hide4096/SaponseEx/README.md

# SaponseEx
マイクロマウス
RT社HM-Starterキットをベースに開発
