hide4096/SaponseEx/CAD/PCB/EncL_PCB.step

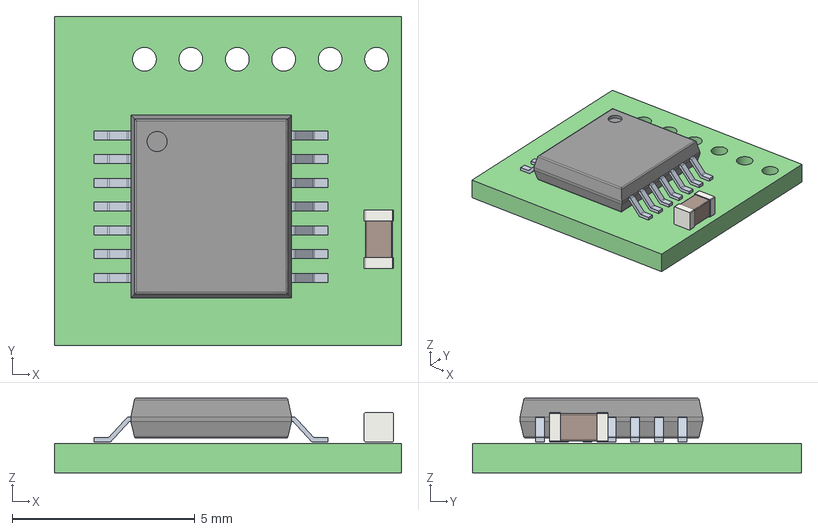
[picture p1: CAD file, 2022-10-14]
CAD/PCB/EncL_PCB.step
9.50 x 9.00 x 2.05 mm
_autosave-SaponseEx PCB
