hide4096/SaponseEx/(list of files, cad)

Other CAD files:
CAD/PCB/EncR_PCB.step
CAD/AIS2022/607ZZ Ball.ipt
CAD/AIS2022/607ZZ Inner ring.ipt
CAD/AIS2022/607ZZ Outer ring.ipt
CAD/AIS2022/607ZZ Shield.ipt
CAD/AIS2022/607ZZ.iam
CAD/AIS2022/673 Ball.ipt
CAD/AIS2022/673 Inner ring.ipt
CAD/AIS2022/673 Outer ring.ipt
CAD/AIS2022/673.iam
CAD/AIS2022/WA673SA Ball.ipt
CAD/AIS2022/WA673SA Inner ring.ipt
CAD/AIS2022/WA673SA Outer ring.ipt
CAD/AIS2022/WA673SA Shield.ipt
CAD/AIS2022/WA673SA.iam
CAD/Board_Parts/LBR127HLD.ipt
CAD/Board_Parts/Lipo.ipt
CAD/Board_Parts/MainBoard.ipt
CAD/Board_Parts/SNZS-M1_6-4.ipt
CAD/Board_Parts/SubBoard.ipt
CAD/CoreLessMotor.ipt
CAD/FL673ZZ.ipt
CAD/FanTurbo.ipt
CAD/FanWing.ipt
CAD/FanWing_open.ipt
CAD/Gear.iam
CAD/Gear/デザイン アクセラレータ/OldVersions/平歯車1.0011.iam
CAD/Gear/デザイン アクセラレータ/OldVersions/平歯車11.0017.ipt
CAD/Gear/デザイン アクセラレータ/mirror/OldVersions/平歯車11_MIR1.0001.ipt
CAD/Gear/デザイン アクセラレータ/mirror/OldVersions/平歯車1_MIR1.0001.iam
CAD/Gear/デザイン アクセラレータ/mirror/平歯車11_MIR.ipt
CAD/Gear/デザイン アクセラレータ/mirror/平歯車11_MIR1.ipt
CAD/Gear/デザイン アクセラレータ/mirror/平歯車1_MIR.iam
CAD/Gear/デザイン アクセラレータ/mirror/平歯車1_MIR1.iam
CAD/Gear/デザイン アクセラレータ/平歯車1.iam
CAD/Gear/デザイン アクセラレータ/平歯車11.ipt
CAD/Gear/デザイン アクセラレータ/平歯車21.ipt
CAD/Gear/デザイン アクセラレータ/足回り_ミラー/OldVersions/平歯車11_MIR1.0001.ipt
CAD/Gear/デザイン アクセラレータ/足回り_ミラー/OldVersions/平歯車1_MIR1.0001.iam
CAD/Gear/デザイン アクセラレータ/足回り_ミラー/平歯車11_MIR.ipt
CAD/Gear/デザイン アクセラレータ/足回り_ミラー/平歯車11_MIR1.ipt
CAD/Gear/デザイン アクセラレータ/足回り_ミラー/平歯車1_MIR.iam
CAD/Gear/デザイン アクセラレータ/足回り_ミラー/平歯車1_MIR1.iam
CAD/GearWheel.ipt
CAD/HeikoPin.ipt
CAD/Magnet.iam
CAD/Magnet.ipt
CAD/MagnetMounter.ipt
CAD/MagnetStopper.ipt
CAD/Magnet_Simple.ipt
CAD/MotorMount.ipt
CAD/MotorMount_New.ipt
CAD/OldVersions/CoreLessMotor.0004.ipt
CAD/OldVersions/FL673ZZ.0032.ipt
CAD/OldVersions/FanWing.0003.ipt
CAD/OldVersions/Gear.0013.iam
CAD/OldVersions/HeikoPin.0036.ipt
CAD/OldVersions/Magnet.0031.ipt
CAD/OldVersions/MagnetMounter.0034.ipt
CAD/OldVersions/Magnet_Simple.0024.ipt
CAD/OldVersions/MotorMount.0064.ipt
CAD/OldVersions/MotorMount_New.0007.ipt
CAD/OldVersions/RT-PN v2.0031.ipt
CAD/OldVersions/SaponseEx.0015.idw
CAD/OldVersions/SaponseEx.0035.iam
CAD/OldVersions/Skirt.0027.ipt
CAD/OldVersions/Spacer.0031.ipt
CAD/OldVersions/Stopper.0043.ipt
CAD/OldVersions/Tire.0034.ipt
CAD/OldVersions/足回り.0065.iam
CAD/PCB/Brains_PCB.ipt
CAD/PCB/EncL_PCB.ipt
CAD/PCB/EncR_PCB.ipt
CAD/PCB/OldVersions/Brains_PCB.0002.ipt
CAD/PCB/OldVersions/EncL_PCB.0001.ipt
CAD/PCB/OldVersions/EncR_PCB.0001.ipt
CAD/PCB/OldVersions/SaponseEx_PCB.0004.ipt
CAD/PCB/SaponseEx_PCB.ipt
CAD/RT-PN v2.ipt
CAD/SaponseEx.iam
CAD/SaponseEx.idw
CAD/Skirt.ipt
CAD/Spacer.ipt
CAD/Stopper.ipt
CAD/Tire.ipt
CAD/mirror/CoreLessMotor_MIR.ipt
CAD/mirror/FL673ZZ_MIR.ipt
CAD/mirror/Gear_MIR.iam
CAD/mirror/HeikoPin_MIR.ipt
CAD/mirror/MagnetMounter_MIR.ipt
CAD/mirror/Magnet_MIR.iam
CAD/mirror/Magnet_MIR.ipt
CAD/mirror/Magnet_Simple_MIR.ipt
CAD/mirror/MotorMount_New_MIR.ipt
CAD/mirror/OldVersions/Gear_MIR.0001.iam
CAD/mirror/OldVersions/MotorMount_New_MIR.0001.ipt
CAD/mirror/OldVersions/Stopper_MIR.0001.ipt
CAD/mirror/OldVersions/足回り_MIR.0002.iam
CAD/mirror/RT-PN v2_MIR.ipt
CAD/mirror/Spacer_MIR.ipt
CAD/mirror/Stopper_MIR.ipt
CAD/mirror/Tire_MIR.ipt
CAD/mirror/足回り_MIR.iam
CAD/吸引/Fan.ipt
CAD/吸引/Fan2.ipt
CAD/吸引/Fan3.ipt
CAD/吸引/Fan4.ipt
CAD/吸引/Fan5.ipt
CAD/吸引/FanMotor.ipt
CAD/吸引/FanMotorMount.ipt
CAD/吸引/OldVersions/Fan.0007.ipt
CAD/吸引/OldVersions/Fan3.0001.ipt
CAD/吸引/OldVersions/Fan4.0002.ipt
CAD/吸引/OldVersions/Fan5.0006.ipt
CAD/吸引/OldVersions/FanMotorMount.0026.ipt
CAD/吸引テスト/Base.ipt
CAD/吸引テスト/OldVersions/mounter.0003.ipt
CAD/吸引テスト/mounter.ipt
CAD/吸引テスト/mounter_top.ipt
CAD/足回り.iam
