hide4096/SaponseEx/PCB/SaponseEx.pdf

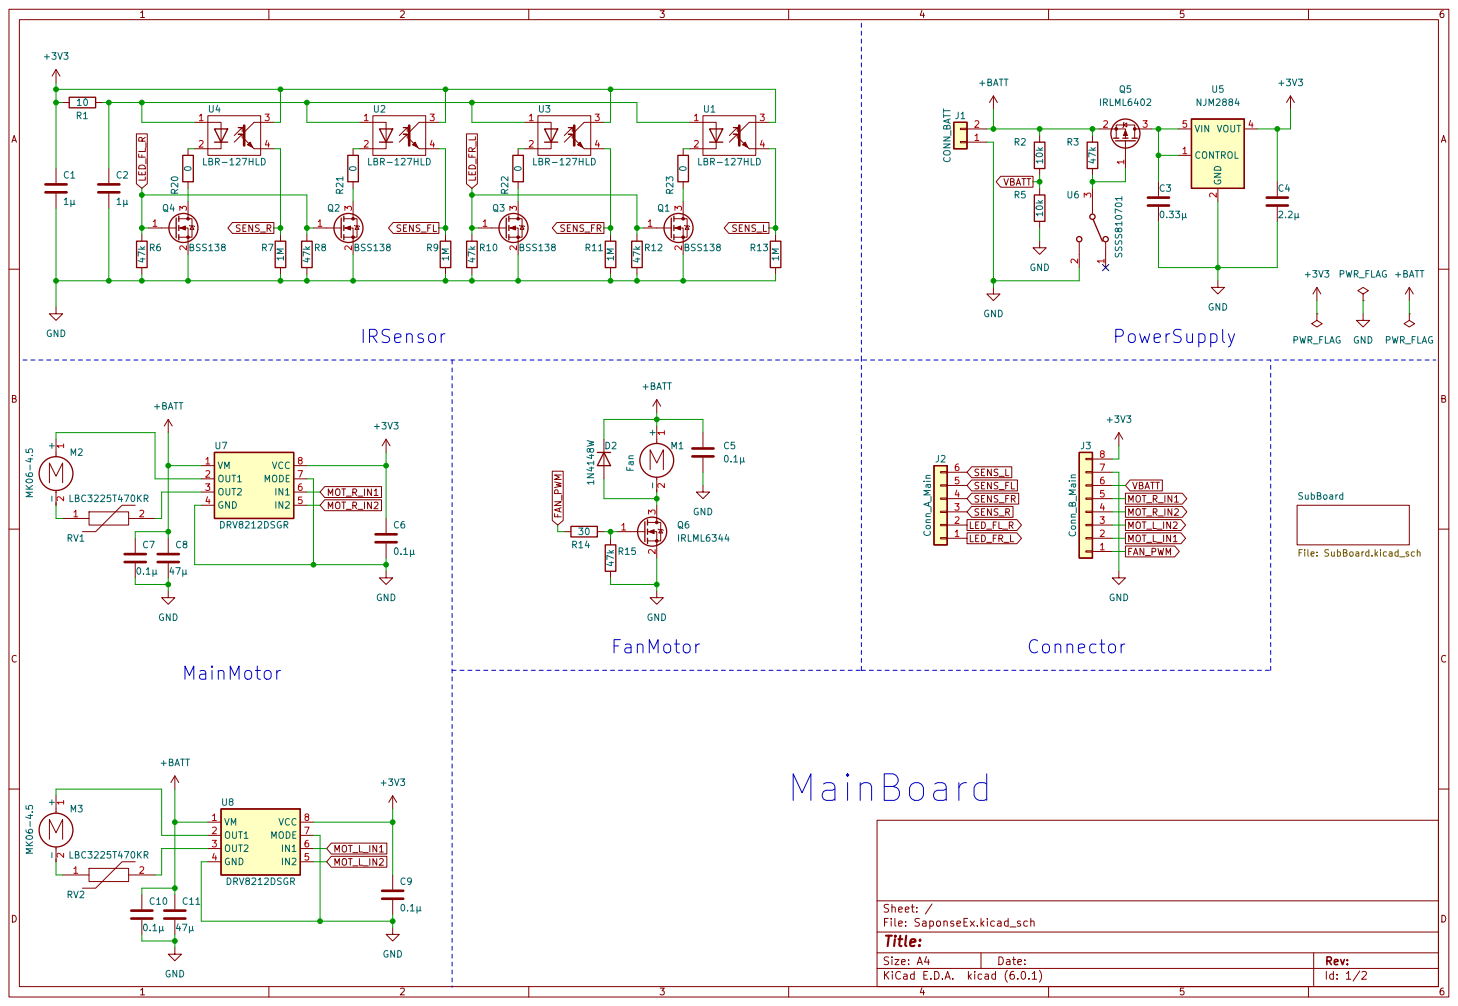
[picture p2: page 1]

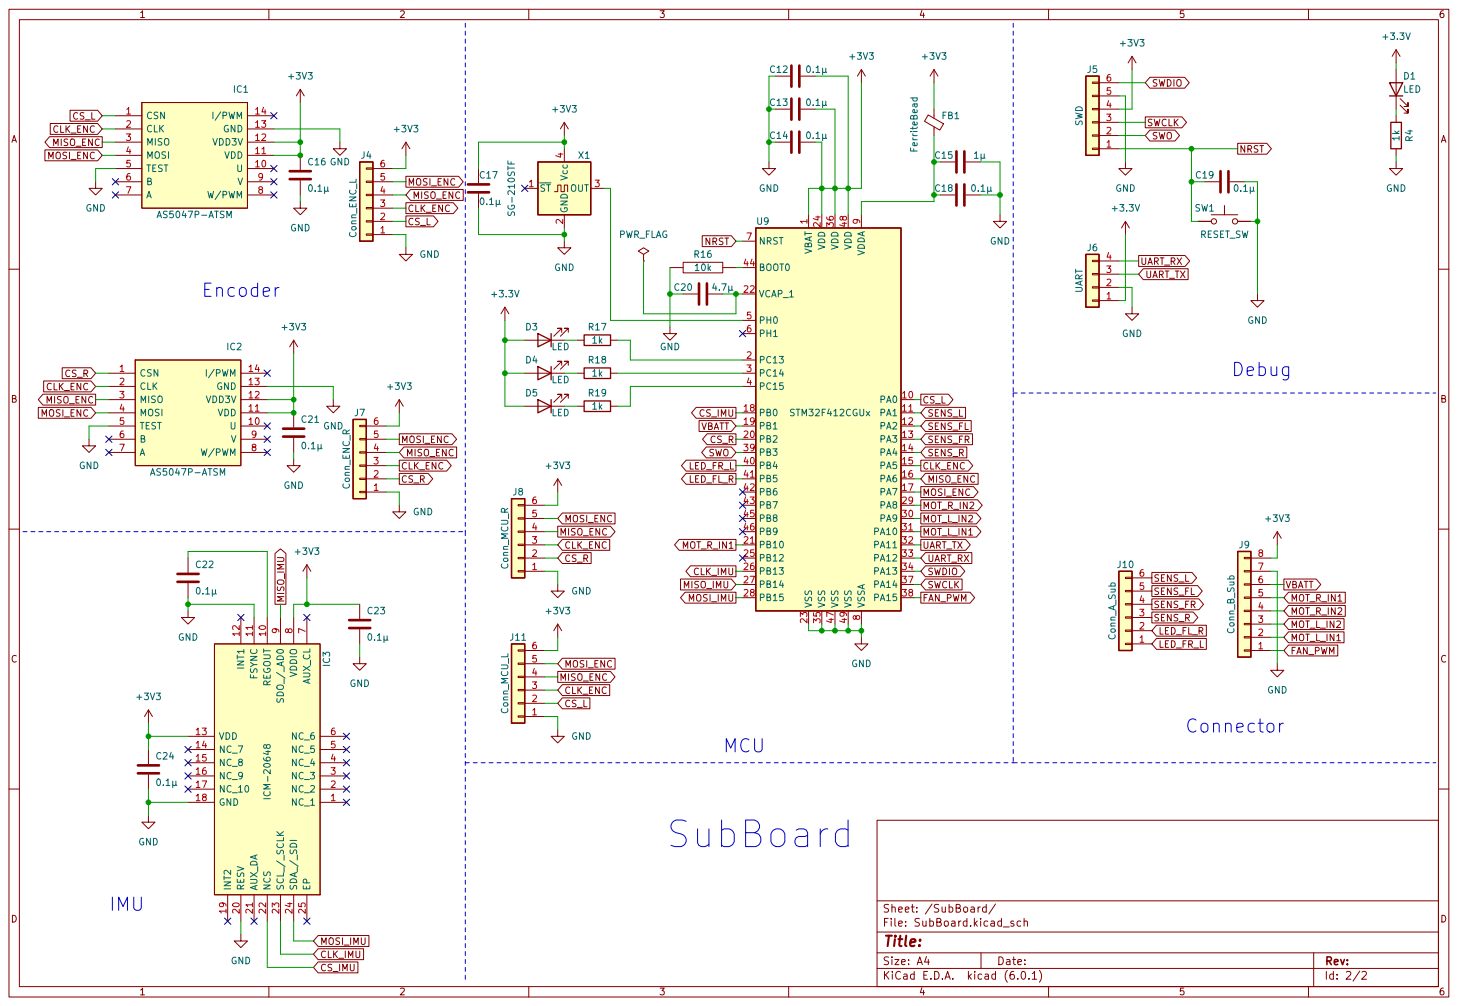
[picture p3: page 2]

8 VDDA U9 9 STM32F412CGUx NC_1 1 REGOUT 10 FSYNC 11 INT1 12 VDD 13 NC_7 14 NC_8 15 NC_9 16 NC_10 17 GND 18 INT2 19 NC_2 2 RESV 20 AUX_DA 21 NCS 22 SCL_/_SCLK 23 SDA_/_SDI 24 EP 25 NC_3 3 NC_4 4 NC_5 5 NC_6 6 AUX_CL

1 PA0 10 PA1 11 PA2 12 PA3 13 PA4 14 PA5 15 PA6 16 PA7 17 PB0 18 PB1 19 PC13 2 PB2 20 PB10 21 VCAP_1 22 VSS 23 VDD 24 PB12 25 PB13 26 PB14 27 PB15 28 PA8 29 PC14 3 PA9 30 PA10 31 PA11 32 PA12 33 PA13 34 VSS 35 VDD 36 PA14 37 PA15 38 PB3 39 PC15 4 PB4 40 PB5 41 PB6 42 PB7 43 BOOT0 44 PB8 45 PB9 46 VSS 47 VDD 48 VSS 49 PH0 5 PH1 6 NRST 7 VSSA

File: SubBoard.kicad_sch Sheet: /SubBoard/
Id: 2/2 Title:
