hide4096/SaponseEx/PCB/SaponseEx.kicad_pcb

## KiCad design PCB/SaponseEx.kicad_pcb (2022-07-28)

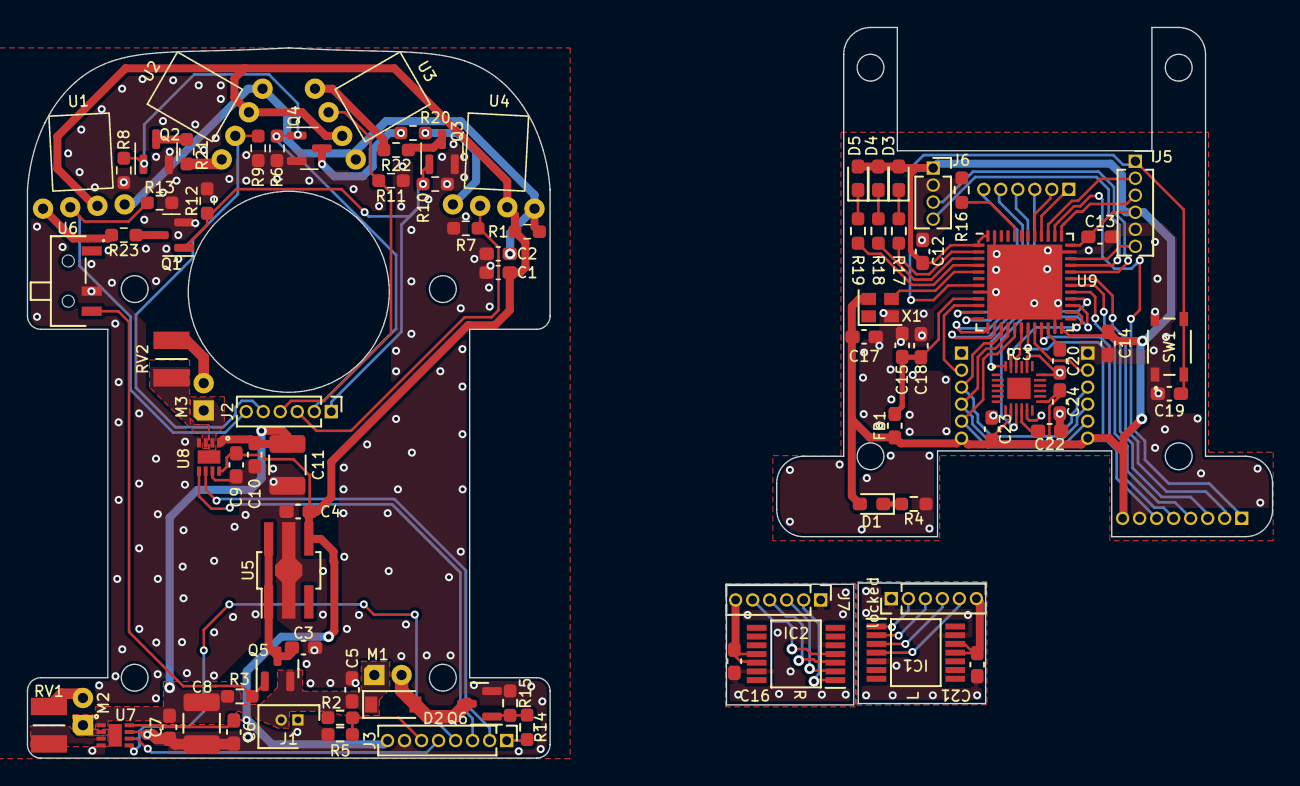
[picture p4: board SaponseEx.kicad_pcb from above]

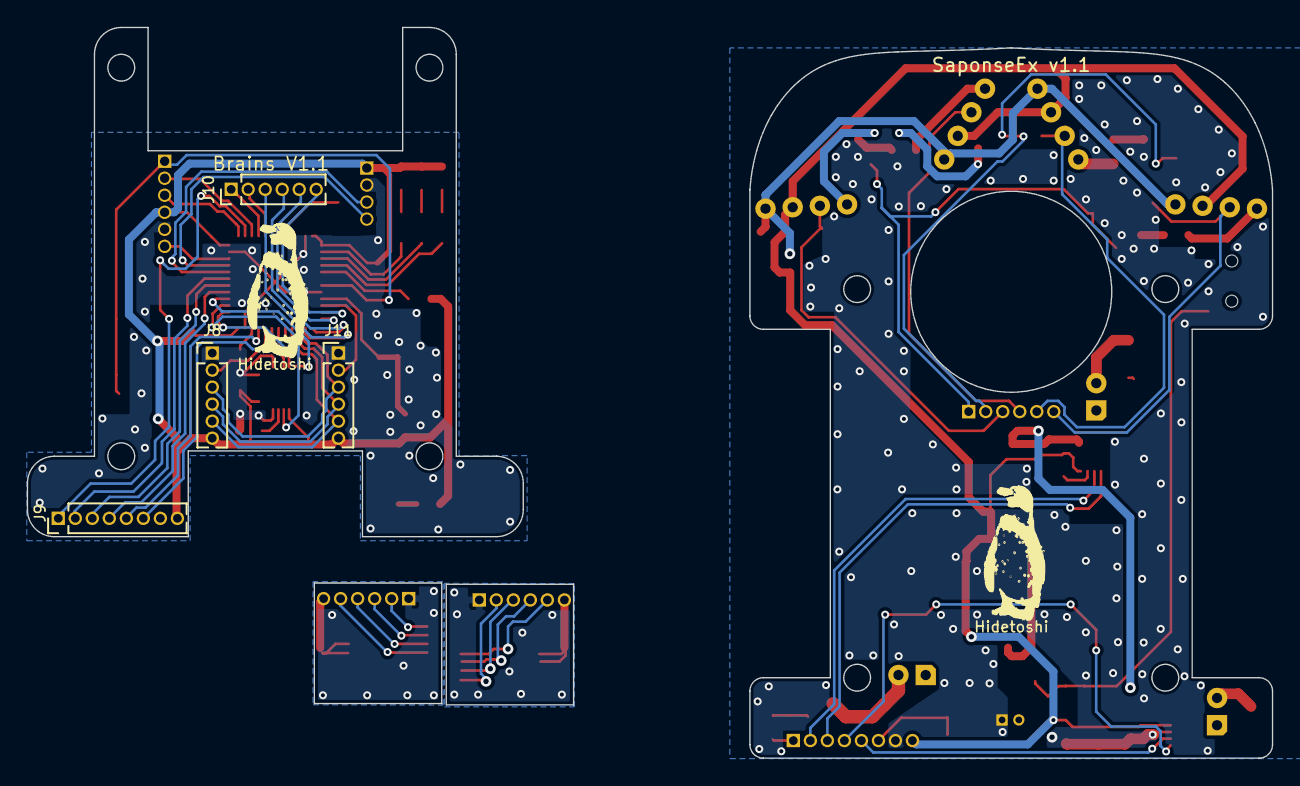
[picture p5: board SaponseEx.kicad_pcb from below]

Board: 2 copper layers, 92.9 x 54.5 mm, 89 parts (4 on the bottom side), 61 nets.

Parts:
C1, C2, C15: 1μ; C_0603_1608Metric_Pad1.08x0.95mm_HandSolder
C3: 0.33μ; C_0603_1608Metric_Pad1.08x0.95mm_HandSolder
C4: 2.2μ; C_0603_1608Metric_Pad1.08x0.95mm_HandSolder
C5, C6, C7, C9, C10, C12, C13, C14, C16, C17, C18, C19, C21, C22, C23, C24: 0.1μ; C_0603_1608Metric_Pad1.08x0.95mm_HandSolder
C8, C11: 47μ; C_1210_3225Metric_Pad1.33x2.70mm_HandSolder
C20: 4.7μ; C_0603_1608Metric_Pad1.08x0.95mm_HandSolder
D1, D3, D4, D5: LED; LED_0603_1608Metric_Pad1.05x0.95mm_HandSolder
D2: 1N4148W; D_SOD-123
FB1: FerriteBead; L_0603_1608Metric_Pad1.05x0.95mm_HandSolder
IC1, IC2: AS5047P-ATSM; SOP65P640X120-14N
IC3: ICM-20648; QFN40P300X300X95-25N-D
J1: CONN_BATT; SHDR2W35P0X125_1X2_425X320X420P
J2: Conn_A_Main; PinHeader_1x06_P1.27mm_Vertical
J3: Conn_B_Main; PinHeader_1x08_P1.27mm_Vertical
J5: SWD; PinSocket_1x06_P1.27mm_Vertical
J6: UART; PinSocket_1x04_P1.27mm_Vertical
J7: Conn_ENC_R; PinHeader_1x06_P1.27mm_Vertical
J8: Conn_MCU_R; PinHeader_1x06_P1.27mm_Vertical
J9: Conn_B_Sub; PinHeader_1x08_P1.27mm_Vertical
J10: Conn_A_Sub; PinHeader_1x06_P1.27mm_Vertical
J11: Conn_MCU_L; PinHeader_1x06_P1.27mm_Vertical
M1: Fan; Motor
M2, M3: MK06-4.5; Motor
Q1, Q2, Q3, Q4: BSS138; SOT-23
Q5: IRLML6402; SOT-23
Q6: IRLML6344; SOT-23
R1: 10; R_0603_1608Metric_Pad0.98x0.95mm_HandSolder
R2, R5, R16: 10k; R_0603_1608Metric_Pad0.98x0.95mm_HandSolder
R3, R6, R8, R10, R12, R15: 47k; R_0603_1608Metric_Pad0.98x0.95mm_HandSolder
R4, R17, R18, R19: 1k; R_0603_1608Metric_Pad0.98x0.95mm_HandSolder
R7, R9, R11, R13: 1M; R_0603_1608Metric_Pad0.98x0.95mm_HandSolder
R14: 30; R_0603_1608Metric_Pad0.98x0.95mm_HandSolder
R20, R21, R22, R23: 0; R_0603_1608Metric_Pad0.98x0.95mm_HandSolder
RV1, RV2: LBC3225T470KR; VARC3225X270N
SW1: RESET_SW; SKRPABE010
U1, U2, U3, U4: LBR-127HLD
U5: NJM2884; SOT-89-5_Handsoldering
U6: SSSS810701
U7, U8: DRV8212DSGR; SON50P200X200X80-9N
U9: STM32F412CGUx; QFN-48-1EP_7x7mm_P0.5mm_EP5.6x5.6mm
X1: SG-210STF; Oscillator_SMD_SeikoEpson_SG210-4Pin_2.5x2.0mm
locked: Conn_ENC_L; PinHeader_1x06_P1.27mm_Vertical

Connections:
+3V3: C1.1, C4.1, C6.1, C9.1, C12.2, C13.2, C14.2, C16.1, C17.1, C21.1, C23.1, C24.1, D1.2 (A), D3.2 (A), D4.2 (A), D5.2 (A), FB1.2, IC1.11 (VDD), IC1.12 (VDD3V), IC2.11 (VDD), IC2.12 (VDD3V), IC3.8 (VDDIO), IC3.13 (VDD), J3.8, J5.4, J6.1, J7.6, J8.6, J9.8, J11.6, R1.1, U1.3, U2.3, U3.3, U4.3, U5.4 (VOUT), U7.8 (VCC), U8.8 (VCC), U9.1 (VBAT), U9.24 (VDD), U9.36 (VDD), U9.48 (VDD), X1.4 (Vcc), locked.6
+BATT: C5.1, C7.1, C8.1, C10.1, C11.1, D2.1 (K), J1.2, M1.1 (+), Q5.2 (S), R2.1, R3.1, U7.1 (VM), U8.1 (VM)
CLK_ENC: IC1.2 (CLK), IC2.2 (CLK), J7.3, J8.3, J11.3, U9.15 (PA5), locked.3
CLK_IMU: IC3.23 (SCL_/_SCLK), U9.26 (PB13)
CS_IMU: IC3.22 (NCS), U9.18 (PB0)
CS_L: IC1.1 (CSN), J11.2, U9.10 (PA0), locked.2
CS_R: IC2.1 (CSN), J7.2, J8.2, U9.20 (PB2)
FAN_PWM: J3.1, J9.1, R14.1, U9.38 (PA15)
GND: C1.2, C2.2, C3.2, C4.2, C5.2, C6.2, C7.2, C8.2, C9.2, C10.2, C11.2, C12.1, C13.1, C14.1, C15.2, C16.2, C17.2, C18.2, C19.2, C20.1, C21.2, C22.2, C23.2, C24.2, IC1.5 (TEST), IC1.13 (GND), IC2.5 (TEST), IC2.13 (GND), IC3.11 (FSYNC), IC3.18 (GND), IC3.20 (RESV), J1.1, J3.7, J5.5, J6.2, J7.1, J8.1, J9.7, J11.1, Q1.2 (S), Q2.2 (S), Q3.2 (S), Q4.2 (S), Q6.2, R4.2, R5.2, R6.2, R7.2, R8.2, R9.2, R10.2, R11.2, R12.2, R13.2, R15.2, R16.1, SW1.1 (A), SW1.2 (A), U5.2 (GND), U6.2, U7.4 (GND), U7.7 (MODE), U8.4 (GND), U8.7 (MODE), U9.8 (VSSA), U9.23 (VSS), U9.35 (VSS), U9.47 (VSS), U9.49 (VSS), X1.2 (GND), locked.1
LED_FL_R: J2.2, J10.2, Q2.1 (G), Q4.1 (G), R6.1, R8.1, U9.41 (PB5)
LED_FR_L: J2.1, J10.1, Q1.1 (G), Q3.1 (G), R10.1, R12.1, U9.40 (PB4)
MISO_ENC: IC1.3 (MISO), IC2.3 (MISO), J7.4, J8.4, J11.4, U9.16 (PA6), locked.4
MISO_IMU: IC3.9 (SDO_/_AD0), U9.27 (PB14)
MOSI_ENC: IC1.4 (MOSI), IC2.4 (MOSI), J7.5, J8.5, J11.5, U9.17 (PA7), locked.5
MOSI_IMU: IC3.24 (SDA_/_SDI), U9.28 (PB15)
MOT_L_IN1: J3.2, J9.2, U8.6 (IN1), U9.31 (PA10)
MOT_L_IN2: J3.3, J9.3, U8.5 (IN2), U9.30 (PA9)
MOT_R_IN1: J3.5, J9.5, U7.6 (IN1), U9.21 (PB10)
MOT_R_IN2: J3.4, J9.4, U7.5 (IN2), U9.29 (PA8)
NRST: C19.1, J5.1, SW1.3 (B), SW1.4 (B), U9.7 (NRST)
unnamed: C2.1, R1.2, U1.1, U2.1, U3.1, U4.1
unnamed: C3.1, Q5.3 (D), U5.1 (CONTROL), U5.5 (VIN)
unnamed: C15.1, C18.1, FB1.1, U9.9 (VDDA)
unnamed: C20.2, U9.22 (VCAP_1)
unnamed: C22.1, IC3.10 (REGOUT)
unnamed: D1.1 (K), R4.1
unnamed: D2.2 (A), M1.2 (-), Q6.3
unnamed: D3.1 (K), R17.1
unnamed: D4.1 (K), R18.1
unnamed: D5.1 (K), R19.1
unnamed: M2.1 (+), U7.2 (OUT1)
unnamed: M2.2 (-), RV1.1
unnamed: M3.1 (+), U8.2 (OUT1)
unnamed: M3.2 (-), RV2.1
unnamed: Q1.3 (D), R23.1
unnamed: Q2.3 (D), R21.1
unnamed: Q3.3 (D), R22.1
unnamed: Q4.3 (D), R20.1
unnamed: Q5.1 (G), R3.2, U6.3
unnamed: Q6.1, R14.2, R15.1
unnamed: R16.2, U9.44 (BOOT0)
unnamed: R17.2, U9.2 (PC13)
unnamed: R18.2, U9.3 (PC14)
unnamed: R19.2, U9.4 (PC15)
unnamed: R20.2, U4.2
unnamed: R21.2, U2.2
unnamed: R22.2, U3.2
unnamed: R23.2, U1.2
unnamed: RV1.2, U7.3 (OUT2)
unnamed: RV2.2, U8.3 (OUT2)
unnamed: U9.5 (PH0), X1.3 (OUT)
SENS_FL: J2.5, J10.5, R9.1, U2.4, U9.12 (PA2)
SENS_FR: J2.4, J10.4, R11.1, U3.4, U9.13 (PA3)
SENS_L: J2.6, J10.6, R13.1, U1.4, U9.11 (PA1)
SENS_R: J2.3, J10.3, R7.1, U4.4, U9.14 (PA4)
SWCLK: J5.3, U9.37 (PA14)
SWDIO: J5.6, U9.34 (PA13)
SWO: J5.2, U9.39 (PB3)
UART_RX: J6.4, U9.33 (PA12)
UART_TX: J6.3, U9.32 (PA11)
VBATT: J3.6, J9.6, R2.2, R5.1, U9.19 (PB1)
