hide4096/SaponseEx/SaponseEx.ioc

Mcu.UserName=STM32F412CGUx
PA0.GPIO_Label=CS_L
PA0.Signal=GPIO_Output
PA1.GPIO_Label=SENS_L
PA1.Signal=ADCx_IN1
PA10.GPIO_Label=MOT_L_IN1
PA10.Signal=S_TIM1_CH3
PA11.Signal=USART6_TX
PA12.Signal=USART6_RX
PA13.Signal=SYS_JTMS-SWDIO
PA14.Signal=SYS_JTCK-SWCLK
PA15.GPIO_Label=FAN
PA15.Signal=GPIO_Output
PA2.GPIO_Label=SENS_FL
PA2.Signal=ADCx_IN2
PA3.GPIO_Label=SENS_FR
PA3.Signal=ADCx_IN3
PA4.GPIO_Label=SENS_R
PA4.Signal=ADCx_IN4
PA5.GPIO_Label=CLK_ENC
PA5.Signal=SPI1_SCK
PA6.GPIO_Label=MISO_ENC
PA6.Signal=SPI1_MISO
PA7.GPIO_Label=MOSI_ENC
PA7.Signal=SPI1_MOSI
PA8.GPIO_Label=MOT_R_IN2
PA8.Signal=S_TIM1_CH1
PA9.GPIO_Label=MOT_L_IN2
PA9.Signal=S_TIM1_CH2
PB0.GPIO_Label=CS_IMU
PB0.Signal=GPIO_Output
PB1.GPIO_Label=VBATT
PB1.Signal=ADCx_IN9
PB10.GPIO_Label=MOT_R_IN1
PB10.Signal=S_TIM2_CH3
PB13.GPIO_Label=CLK_IMU
PB13.Signal=SPI2_SCK
PB14.GPIO_Label=MISO_IMU
PB14.Signal=SPI2_MISO
PB15.GPIO_Label=MOSI_IMU
PB15.Signal=SPI2_MOSI
PB2.GPIO_Label=CS_R
PB2.Signal=GPIO_Output
PB3.Signal=SYS_JTDO-SWO
PB4.GPIO_Label=LED_FR_L
PB4.Signal=GPIO_Output
PB5.GPIO_Label=LED_FL_R
PB5.Signal=GPIO_Output
PC13.GPIO_Label=D3
PC13.Signal=GPIO_Output
PC14-OSC32_IN.GPIO_Label=D4
PC14-OSC32_IN.Signal=GPIO_Output
PC15-OSC32_OUT.GPIO_Label=D5
PC15-OSC32_OUT.Signal=GPIO_Output
