hide4096/SaponseEx/Main/Src/motor.c

/* 
#####################################
    Motor Control & Encoder & IMU
#####################################
*/

#include"motor.h"

static int16_t b_encR_val=0,b_encL_val=0;
static float b_spd =0;
static float r_yaw = 0,r_yaw_new = 0,r_b_yaw;
static float before_spd=0.;
static float before_angvel=0.;
static float spdR,spdL;

uint8_t runmode=DISABLE_MODE;
uint8_t wallfix_is = DISABLE_MODE;
int8_t turndir = LEFT;
float spd,deg,len;
float accel = 0.,ang_accel = 0.;
float max_spd = 0.;
float max_angvel = 0.;
float angvel,r_yaw_ref;
float tgt_spd=0.,tgt_angvel=0.;
float tvR = 0.,tvL=0.;
int16_t encR_val,encL_val;
int16_t d_encR_val,d_encL_val;

float I_spd = 0.;
float I_angvel = 0.;
int I_error = 0.;


AS5047P_Instance encR;
AS5047P_Instance encL;

void SetDutyRatio(float motL,float motR,uint8_t motR_isCW,uint8_t motL_isCW){

  if(runmode != DISABLE_MODE){
    if(motR > 1.0) motR = 1.0;
    if(motL > 1.0) motL = 1.0;

    
    if(motL_isCW){
      __HAL_TIM_SET_COMPARE(&htim1,TIM_CHANNEL_2,(1.0-motL)*MTPERIOD);
      __HAL_TIM_SET_COMPARE(&htim1,TIM_CHANNEL_3,MTPERIOD);  
    }else{
      __HAL_TIM_SET_COMPARE(&htim1,TIM_CHANNEL_2,MTPERIOD);
      __HAL_TIM_SET_COMPARE(&htim1,TIM_CHANNEL_3,(1.0-motL)*MTPERIOD);
    }

    if(!motR_isCW){
      __HAL_TIM_SET_COMPARE(&htim1,TIM_CHANNEL_1,(1.0-motR)*MTPERIOD);
      __HAL_TIM_SET_COMPARE(&htim2,TIM_CHANNEL_3,MTPERIOD);
    }else{
      __HAL_TIM_SET_COMPARE(&htim1,TIM_CHANNEL_1,MTPERIOD);
      __HAL_TIM_SET_COMPARE(&htim2,TIM_CHANNEL_3,(1.0-motR)*MTPERIOD);
    }

  }else{
    __HAL_TIM_SET_COMPARE(&htim1,TIM_CHANNEL_1,MTPERIOD);
    __HAL_TIM_SET_COMPARE(&htim2,TIM_CHANNEL_3,MTPERIOD);
    __HAL_TIM_SET_COMPARE(&htim1,TIM_CHANNEL_2,MTPERIOD);
    __HAL_TIM_SET_COMPARE(&htim1,TIM_CHANNEL_3,MTPERIOD);
  }
}

void GetSpeed(){

  //エンコーダ読む
  encR_val = AS5047P_ReadPosition(&encR, AS5047P_OPT_ENABLED);
  encL_val = AS5047P_ReadPosition(&encL, AS5047P_OPT_ENABLED);
	if(AS5047P_ErrorPending(&encR)) AS5047P_ErrorAck(&encR);
	if(AS5047P_ErrorPending(&encL)) AS5047P_ErrorAck(&encL);

  //差分とる
  d_encR_val = encR_val - b_encR_val;
  d_encL_val = b_encL_val -  encL_val;
  b_encR_val = encR_val;
  b_encL_val = encL_val;

  //0と16383とかまたいだ時の処理
  //秒速98.2m/s超えるとバグる（笑）
  if(d_encR_val > ENC_HALF)   d_encR_val -= ENC_MAX-1;
  if(d_encR_val < -ENC_HALF)  d_encR_val += ENC_MAX-1;
  if(d_encL_val > ENC_HALF)   d_encL_val -= ENC_MAX-1;
  if(d_encL_val < -ENC_HALF)  d_encL_val += ENC_MAX-1;

  //進んだ距離計算する
  float lenR = (float)d_encR_val * (float)PPMM;
  float lenL = (float)d_encL_val * (float)PPMM;
  //走行距離に入れる
  len += (lenR + lenL) / 2.0;

  //進んだ距離(mm)から速度(m/s)計算する
  spdR = (lenR / 1000.) / DELTA_T;
  spdL = (lenL / 1000.) / DELTA_T;

  //機体全体の速度を計算する
  float enc_spd = (spdL + spdR) / 2.0;
  spd = ALPHA*(b_spd + accelY()*9.8*DELTA_T) + (1-ALPHA)*enc_spd; 
  b_spd = spd;
}

void ControlDuty(){
  float vR = 0.,vL = 0.;

  //速度生成

  switch(runmode){
    case STRAIGHT_MODE:
      tgt_spd += accel/1000.;
      if(tgt_spd > max_spd) tgt_spd = max_spd;
      break;
    
    case TURN_MODE:
      tgt_spd += accel/1000.;
      if(tgt_spd > max_spd) tgt_spd = max_spd;

      tgt_angvel += ang_accel/1000.0;
      if(turndir == LEFT){
        if(tgt_angvel > max_angvel) tgt_angvel = max_angvel;
      }else if(turndir == RIGHT){
        if(tgt_angvel < max_angvel) tgt_angvel = max_angvel;
      }
      break;
  }

  //壁制御
  if(runmode == STRAIGHT_MODE){
    if(wallfix_is == ENABLE_MODE){
      //壁あるか確認
      uint8_t fl_wall_is = 0,fr_wall_is = 0;
      if(sensval[FL] >= WALL_TH_FL) fl_wall_is = 1;
      if(sensval[FR] >= WALL_TH_FR) fr_wall_is = 1;

      /*
        壁との距離から目標コースとのずれを測る
        壁の有無に応じて切り替えるよ
      */

      int error = 0;
      if(fl_wall_is && fr_wall_is){
        error = (sensval[FR] - REF_FR) - (sensval[FL] - REF_FL); 
      }else if(fl_wall_is){
        error = (sensval[FL] - REF_FL)*-2;
      }else if(fr_wall_is){
        error = (sensval[FR] - REF_FR)*2;
      }

      //PIDして目標角速度に出力
      I_error += error;
      if(I_error > WALLERROR_I_MAX) I_error = WALLERROR_I_MAX;
      if(I_error < -WALLERROR_I_MAX) I_error = -WALLERROR_I_MAX;
      tgt_angvel = (error * WALL_KP + I_error * WALL_KI)/1000.;
    }else{
      tgt_angvel = 0.;
      I_error = 0.;
    }
  }

  /*
  //速度フィードフォワード
  const int Mass = 24.22;
  float torque = ((Mass / 1000.)* accel * (TIRE_DIAM / 2.)) / ((38./9.)*4.);
  float v_acc_r = 5.9*(torque*(1./0.594))  + (((d_encR_val/ENC_MAX)/DELTA_T)*60.)*0.062*1000.;
  float v_acc_l = 3.9*(torque*(1./0.594))  + (((d_encL_val/ENC_MAX)/DELTA_T)*60.)*0.062*1000.;
  */

  //速度フィードバック
  float diff_spd = tgt_spd - spd;
  float v_spd = diff_spd*SPD_KP+I_spd*SPD_KI+(spd - before_spd)/LOOPFREQ*SPD_KD;
  before_spd = spd;
  I_spd+=diff_spd/LOOPFREQ;
  if(I_spd > SPD_I_MAX) I_spd = SPD_I_MAX;
  else if(I_spd < -SPD_I_MAX) I_spd = -SPD_I_MAX;

  //角速度フィードバック
  float diff_angvel = tgt_angvel-angvel;
  float v_angvel = diff_angvel*ANGVEL_KP+I_angvel*ANGVEL_KI+(angvel - before_angvel)/LOOPFREQ*ANGVEL_KD;
  before_angvel = angvel;
  I_angvel+=diff_angvel/LOOPFREQ;
  if(I_angvel > ANGVEL_I_MAX) I_angvel = ANGVEL_I_MAX;
  else if(I_angvel < -ANGVEL_I_MAX) I_angvel = -ANGVEL_I_MAX;


  //合算
  //vR = (2/TIRE_DIAM)*(tgt_spd+v_spd) + (WHEELDIST/TIRE_DIAM)*(tgt_angvel+v_angvel);
  //vL = (2/TIRE_DIAM)*(tgt_spd+v_spd) - (WHEELDIST/TIRE_DIAM)*(tgt_angvel+v_angvel);

  //vR*=62.;
  //vL*=62.;

  vR = v_spd + v_angvel;
  vL = v_spd - v_angvel;


  //電圧をデューティ比に変換
  uint8_t motL_isCW = 0;
  uint8_t motR_isCW = 1;
  if(vL < 0){
    motL_isCW = 1;
    vL*=-1.;
  }
  if(vR < 0){
    motR_isCW = 0;
    vR*=-1.;
  }

  if(runmode == TEST_MODE){
    motR_isCW = 1;
    motL_isCW = 0;

    if(tvR < 0){
      motR_isCW = 0;
      vR = -tvR;
    }else{
      vR = tvR;
    }
    if(tvL < 0){
      motL_isCW = 1;
      vL = -tvL;
    }else{
      vL = tvL;
    }
  }

  float dutyR = (vR*(1.+R_DIFF))/vbat;
  float dutyL = (vL*(1.-R_DIFF))/vbat;

  //デューティ比を設定
  SetDutyRatio(dutyL,dutyR,motR_isCW,motL_isCW);
}

static uint8_t cnt_disarm = 0;

void FailSafe(){
  if(vbat > LOWVOLT){
    cnt_disarm=0;
    return;
  }

  cnt_disarm++;

  if(cnt_disarm >= 150){
    HAL_TIM_PWM_Stop(&htim1, TIM_CHANNEL_2);
    HAL_TIM_PWM_Stop(&htim1, TIM_CHANNEL_3);
    HAL_TIM_PWM_Stop(&htim1, TIM_CHANNEL_1);
    HAL_TIM_PWM_Stop(&htim2, TIM_CHANNEL_3);
    HAL_GPIO_WritePin(FAN_GPIO_Port,FAN_Pin,0);
    HAL_TIM_Base_Stop_IT(&htim6);  //interrupt 2kHz
    HAL_TIM_Base_Stop_IT(&htim7);  //interrupt 1kHz
    HAL_TIM_Base_Stop_IT(&htim10);  //interrupt 4kHz
    HAL_GPIO_WritePin(GPIOB,GPIO_PIN_4,0);
    HAL_GPIO_WritePin(GPIOB,GPIO_PIN_5,0);

    led=0;
    SetLED();

    while(1) Blink(10);
  }
}

void GetYawDeg(){
  r_yaw_new = K*(gyroZ() - r_yaw_ref);
  
  r_b_yaw = r_yaw;
  r_yaw = r_b_yaw * IMULPF + r_yaw_new * (1.0 - IMULPF);

  angvel = r_yaw*(M_PI/180.);

  deg += r_yaw * DELTA_T;
}
