hide4096/SaponseEx/Main/Src/odom.c

/* 
################
    Odometry
################
*/

#include"odom.h"

float pos_x=0,pos_y=0;
uint32_t chase_phase = 0;

void CalcPosition(){
    float rad = deg *(M_PI / 180.);
    float spd_ms = spd * 1000.;
    pos_x+=spd_ms*DELTA_T*-sin(rad);
    pos_y+=spd_ms*DELTA_T*cos(rad);
}

float traject[][3]={{0.0000000000,0.0000000000,0.0000000000},
{1.0000000000,0.0000008397,0.0000033588},
{1.9999999997,0.0000134079,0.0000268546},
{2.9999999985,0.0000679628,0.0000906123},
{3.9999999734,0.0002147870,0.0002146653},
{4.9999978427,0.0005240710,0.0004189152},
{5.9999940292,0.0010859132,0.0007231311},
{6.9999905170,0.0020082394,0.0011465832},
{7.9999882820,0.0034209190,0.0017086556},
{8.9999872924,0.0054750013,0.0024288363},
{9.9999865077,0.0083390077,0.0033261415},
{10.9999838799,0.0121989319,0.0044191159},
{11.9999763525,0.0172582400,0.0057258329},
{12.9999598610,0.0237378701,0.0072638941},
{13.9999293329,0.0318762330,0.0090504297},
{14.9998786876,0.0419292115,0.0111020983},
{15.9998008362,0.0541701608,0.0134350869},
{16.9996876820,0.0688899084,0.0160651111},
{17.9995301200,0.0863953912,0.0190074149},
{18.9993141823,0.1069951809,0.0222767708},
{19.9990130216,0.1310293330,0.0258874797},
{20.9986123071,0.1588539644,0.0298532220},
{21.9980919825,0.1908340272,0.0341863064},
{22.9974239411,0.2273433085,0.0388988969},
{23.9965720257,0.2687644307,0.0440024886},
{24.9954920281,0.3154888514,0.0495077690},
{25.9941316897,0.3679168633,0.0554246175},
{26.9924307012,0.4264575941,0.0617621062},
{27.9903207027,0.4915290068,0.0685284991},
{28.9877252835,0.5635578997,0.0757312526},
{29.9845599824,0.6429799059,0.0833770154},
{30.9807322876,0.7302394939,0.0914716284},
{31.9761416366,0.8257899674,0.1000201249},
{32.9706793465,0.9300746837,0.1090267303},
{33.9642129674,1.0435268060,0.1184948623},
{34.9565965653,1.1666119802,0.1284271309},
{35.9476781234,1.2997892378,0.1388252402},
{36.9372897836,1.4435100265,0.1496898381},
{37.9252478459,1.5982182097,0.1610207165},
{38.9113527690,1.7643500673,0.1728168303},
{39.8953891701,1.9423342946,0.1850762970},
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

void GenerateChase(){
    chase_phase = len;
    if(chase_phase >= 140){
        runmode = DISABLE_MODE;
        return;
    }

    float tgt_x = traject[chase_phase][0];
    float tgt_y = traject[chase_phase][1];
    float tgt_rad = traject[chase_phase][2];

    float rad = deg *(M_PI / 180.);
    float cos_rad = cos(rad),sin_rad = sin(rad);

    float err_x = (tgt_x - pos_x)*cos_rad+(tgt_y - pos_y)*sin_rad;
    float err_y = -(tgt_x - pos_x)*sin_rad+(tgt_y - pos_y)*cos_rad;
    float err_theta = rad - tgt_rad;


    tgt_spd = tgt_spd*cos(err_theta) + KX*err_x;
    tgt_angvel = tgt_angvel + tgt_spd*(KY*err_y + KT*sin(err_theta));
}
