hide4096/SaponseEx/Main/Inc/analog.h

/* 
#############################
    Wall Sensor & voltage
#############################
*/
#ifndef ANALOG_H
#define ANALOG_H

#include"main.h"
#include"adc.h"

extern uint16_t adcval[9];
extern int16_t sensval[4];
extern float vbat;

void TrigWallSens();
void GetBattVoltage();
void FetchWallSens();

#endif
