hide4096/SaponseEx/Core/Inc/system.h

/* 
###############################
    System Interrupt & Init
###############################
*/
#ifndef SYSTEM_H
#define SYSTEM_H

#include"main.h"
#include"analog.h"
#include"motor.h"
#include"tim.h"
#include"show.h"

void DoPanic();
void init();

#endif
