hide4096/SaponseEx/(commit log)

2022-07-30 赤外線センサにFFTでフィルタを追加
2022-07-30 [update]センサのフーリエ変換を手実装
2022-07-30 [update]DSPLIbraryを削除
2022-07-30 [fix]フーリエ変換の処理を見直し(実機まだ)
2022-07-30 [fix]バグを修正（実機まだ）
2022-07-31 [fix]フィルタ使わない方がいいじゃん
2022-08-01 [update]センサー、モータ制御追加
2022-08-02 [update]モータ制御、Panic追加
2022-08-02 [fix]センサの初期化処理を修正
2022-08-03 [fix]PWMのstart忘れを修正
2022-08-03 [update]速度計算追加
2022-08-03 [update]速度、角速度取得
2022-08-03 [update]ドリフト修正
2022-08-03 [update]速度、角度制御を簡易的に実装(Pだけだけど)
2022-08-03 [update]メニュー実装
2022-08-05 [fix]バッテリ残量を補正
2022-08-07 [fix]ローパスフィルタのゲインを調整
2022-10-14 [add]CADデータを追加
    [607ZZ Ball.ipt, 607ZZ Inner ring.ipt, 607ZZ Outer ring.ipt, 607ZZ Shield.ipt, 607ZZ.iam, 673 Ball.ipt, 673 Inner ring.ipt, 673 Outer ring.ipt]
2022-10-14 [update]モーターマウントを改良
    [Gear.0007.iam, Gear.0008.iam, Gear.iam, SaponseEx.0004.iam, SaponseEx.0005.iam, SaponseEx.iam, 平歯車1.0007.iam, 平歯車1.0008.iam]
2022-10-14 [update]スカート追加
    [Brains_PCB.0001.ipt, Brains_PCB.0002.ipt, Brains_PCB.ipt, CoreLessMotor.0002.ipt, CoreLessMotor.0004.ipt, CoreLessMotor.ipt, CoreLessMotor_MIR.ipt, FL673ZZ.0030.ipt]
2022-10-14 [update]ファンいじった
    [SaponseEx.0007.idw, SaponseEx.0008.idw, SaponseEx.idw, Stopper.0042.ipt, Stopper.0043.ipt, Stopper.ipt]
2022-10-19 [update]IMUドライバ変更
2022-10-19 [update]IMUドライバを変更
    [Fan4.0001.ipt, Fan4.0002.ipt, Fan4.ipt, Fan5.0004.ipt, Fan5.ipt, SaponseEx.0008.idw, SaponseEx.0010.idw, SaponseEx.0024.iam]
2022-10-19 [fix]一部処理を分割
    [Fan5.0004.ipt, Fan5.0005.ipt, Fan5.ipt]
2022-10-19 [fix]エンコーダードライバを移動
2022-10-19 [fix]gitignoreを反映
    [607ZZ Ball.ipt, 607ZZ Inner ring.ipt, 607ZZ Outer ring.ipt, 607ZZ Shield.ipt, 607ZZ.iam, 673 Ball.ipt, 673 Inner ring.ipt, 673 Outer ring.ipt]
2022-10-19 [fix]gitignore反映
    [607ZZ Ball.ipt, 607ZZ Inner ring.ipt, 607ZZ Outer ring.ipt, 607ZZ Shield.ipt, 607ZZ.iam, 673 Ball.ipt, 673 Inner ring.ipt, 673 Outer ring.ipt]
2022-10-19 [add]ファイル分割した
2022-10-19 [fix]IMUの感度変更を改良
2022-10-19 [update]PID追加
2022-10-19 [fix]メニュー修正
2022-10-19 [fix]初期化を修正
2022-10-21 [update]宴会芸を追加
    [FanMotorMount.0018.ipt, FanMotorMount.0019.ipt, FanMotorMount.ipt]
2022-10-23 [update]壁センサを省電力化
    [FanMotorMount.0019.ipt, FanMotorMount.0023.ipt, FanMotorMount.ipt, SaponseEx.0010.idw, SaponseEx.0012.idw, SaponseEx.0025.iam, SaponseEx.0029.iam, SaponseEx.iam]
2022-10-23 [fix]モータカット機能を修正
    [Fan5.0005.ipt, Fan5.0006.ipt, Fan5.ipt, FanMotorMount.0023.ipt, FanMotorMount.0024.ipt, FanMotorMount.ipt, SaponseEx.0012.idw, SaponseEx.0013.idw]
2022-10-23 [update]あ
    [FanMotorMount.0024.ipt, FanMotorMount.0025.ipt, FanMotorMount.ipt, SaponseEx.0031.iam, SaponseEx.0032.iam, SaponseEx.iam, Skirt.0022.ipt, Skirt.0023.ipt]
2022-10-28 [update]タイマー割り込みの周波数を5kHzにした
2022-10-28 [fix]ファンのトリガー処理を変更
2022-10-28 [fix]速度や角速度の単位を修正
2022-10-28 [fix]変数名ちゃんと変えてなかった
2022-10-28 [update]自動生成のコードを分離
2022-10-28 [add]buildディレクトリ追加
2022-10-28 [fix]速度計算を修正
    [607ZZ Ball.ipt, 607ZZ Inner ring.ipt, 607ZZ Outer ring.ipt, 607ZZ Shield.ipt, 607ZZ.iam, 673 Ball.ipt, 673 Inner ring.ipt, 673 Outer ring.ipt]
2022-10-28 [fix]buildディレクトリやっぱ消す
    [607ZZ Ball.ipt, 607ZZ Inner ring.ipt, 607ZZ Outer ring.ipt, 607ZZ Shield.ipt, 607ZZ.iam, 673 Ball.ipt, 673 Inner ring.ipt, 673 Outer ring.ipt]
2022-10-28 [update]ゲイン調整
2022-10-28 [update]壁制御追加
2022-10-28 [fix]壁制御のゲイン調整
2022-10-29 [fix]壁センサのDMA処理がまずかった
2022-10-29 [update]壁補正追加
2022-11-04 [fix]げいんちょうせい
2022-11-17 [fix]IMUの初期化処理を修正
    [SaponseEx.0013.idw, SaponseEx.0014.idw, SaponseEx.idw]
2022-11-20 [update]タイマーの設定とSPIの速度を変更
2022-11-20 [fix]曲芸のやつを修正
2022-11-20 [fix]モード選択の処理を修正
2022-11-20 [fix]さっきのビルド通らなかったので修正
2022-11-20 [add]タイマー追加
2022-11-20 [update]モータ制御の処理を変更
2022-11-20 [add]壁制御を追加
2022-11-20 [add]とりあえず直進の処理書いた
2022-11-20 [fix]走るようにした
2022-11-20 [fix]壁センサの不具合を修正
2022-11-21 [fix]直進の巡行までの処理を修正
2022-11-21 [fix]無限走行に陥るバグを修正
2022-11-21 [add]旋回を実装した
2022-11-22 [fix]ちゃんとターンした
2022-11-22 [fix]しっかり旋回したよ
2022-11-22 [fix]ヘッダファイルの関係を修正
2022-11-22 [fix]グローバル変数の定義が冗長だったので整理
2022-11-22 [add]探索走行作るよ
2022-11-22 [add]足立法の機能ちょっと書いた
2022-11-22 [update]足立法もうちょい書いた
2022-11-22 [update]足立法を実装
2022-11-23 [fix]迷路は解けてそう
2022-11-25 [fix]ゲイン調整
2022-11-26 [fix]IMUの生値からの変換処理を修正
2022-11-26 [fix]Straightを修正
2022-11-26 [fix]走行の処理を修正
2022-11-26 [fix]CWCCWが逆でした
2022-11-26 [update]SPI読み取り速度アップ
2022-11-26 [fix]デバッグ用処理抜いた
2022-11-26 [fix]回転方向が逆でした
2022-11-26 [update]ヘッダファイルの関数の定義を改良
2022-11-26 [fix]旋回処理を修正
2022-11-26 [fix]電圧を校正
2022-11-26 [update]ゴール座標変更
2022-11-26 [update]ADCの読み方を改良
2022-11-26 [update]壁センサの発光パターン変えた
2022-12-09 [add]BLE機能を追加
    [Gear.0008.iam, Gear.0010.iam, Gear.iam, MotorMount_New.0005.ipt, MotorMount_New.0007.ipt, MotorMount_New.ipt, 平歯車1.0008.iam, 平歯車1.0009.iam]
2022-12-09 [fix]iocファイル反映
2022-12-10 [fix]ITM_SendCharを修正
2022-12-10 [fix]グラフ描画を追加
2022-12-10 [add]グラフ追加
2022-12-18 [update]PWMの与え方を変更
2022-12-18 [add]モーターテスト処理を追加
2022-12-18 [add]PWMモードを切り替えられるようにした
2022-12-18 [add]PWM方式切り替え機能の追加
2022-12-18 [update]キャリア周波数をいい感じに変化させる
2022-12-20 [fix]壁センサの配線ミスを修正
    [SaponseEx.kicad_sch, SubBoard.kicad_sch]
2022-12-20 [update]ADC回り足してみた
2022-12-22 [update]ADC調整
2022-12-22 [update]任意電圧を印加できるようにした
2022-12-22 [add]メモリ消去を追加
2022-12-22 [update]ログ機能追加(いろいろ壊すけど)
2022-12-22 [fix].gitignoreを修正
2022-12-22 [fix]領域外に書き込んじゃってた
2022-12-22 [update]システム同定を適用
2022-12-25 [add]システム同定やってみた
    [rotate_2v.csv, rotate_5v.csv, straight_1v.csv, straight_2v.csv]
2022-12-25 [fix]PID処理全然違うじゃん
2022-12-26 [update]ログ形式変えた
2022-12-26 [update]制御をちょっと変えた
    [rotate_4v.csv, rotate_6v.csv]
2023-01-11 [fix]モタドラのスリープ回避
2023-01-11 [fix]PWMの設定がミスってた
2023-01-13 [update]相補フィルタを追加
2023-01-15 [fix]spinturnの減速処理修正
2023-01-15 [update]ゲイン調整完了
2023-01-15 [add]壁センサをグラフに出力
2023-01-15 [update]iocファイルとの整合性とった
2023-01-17 [fix]タイヤのゴム脱落を防止
    [Gear.0010.iam, Gear.0011.iam, Gear.iam, 平歯車1.0009.iam, 平歯車1.0010.iam, 平歯車1.iam, 平歯車11.0015.ipt, 平歯車11.0017.ipt]
2023-01-28 [fix]ギアホイール改修
    [Gear.0011.iam, Gear.0012.iam, Gear.iam, Gear_MIR.0001.iam, Gear_MIR.iam, MotorMount_New_MIR.0001.ipt, MotorMount_New_MIR.ipt, SaponseEx.0032.iam]
2023-01-28 [add]ADCのウェイトをまとめた
2023-01-28 [fix]タイマー調整
2023-01-28 [fix]発光パターンを修正
2023-01-28 [add]マップ吐き出し
2023-01-29 [fix]マップ修正
2023-01-30 [fix]壁を検知できなかったときに範囲外にアクセスするバグを修正
2023-02-05 [add]壁センサのログとる
2023-02-05 [add]角度調整する
2023-02-05 [fix]直線走行のバグを修正
2023-02-05 [fix]前壁の判定を変更
2023-02-05 [fix]壁設置のバグ修正
2023-02-05 [fix]足立法のバグ修正
2023-02-08 [update]ADC読み取りをポーリングに変更
2023-02-08 [update]リポ電圧の監視を修正
2023-02-08 [fix]壁制御のゲインを調整
    [SaponseEx.kicad_sch, SubBoard.kicad_sch]
2023-02-14 [fix]壁補正の符号が反転してた
2023-02-14 [add]壁センサログ追加
2023-02-14 [fix]センサ値表示を綺麗にした
2023-02-14 [add]オドメトリ追加
2023-02-14 [add]座標をログに書き込み
2023-02-14 [add]ログ周期変更
2023-02-14 [add]吸引ファン作った
    [FanWing.ipt]
2023-02-15 [add]吸引ファン修正
    [FanWing.0001.ipt, FanWing.ipt]
2023-02-15 [add]軌道追従を実装した,,,?
2023-02-18 [add]スラローム追加
2023-02-18 [fix]Dゲインの処理がおかしかった
2023-02-18 [fix]壁補正の閾値を修正
2023-02-18 [fix]スラローム調整
2023-03-04 [add]吸引ファン試験機追加
    [Base.ipt, SubBoard_alpha.kicad_sch, mounter.0003.ipt, mounter.ipt, mounter_top.ipt]
2023-03-04 [add]ファン追加
    [FanMotorMount.0025.ipt, FanMotorMount.0026.ipt, FanMotorMount.ipt, FanTurbo.ipt, FanWing.0001.ipt, FanWing.0003.ipt, FanWing.ipt, FanWing_open.ipt]
2023-04-05 [fix]gitignore編集
2023-04-05 [fix]コミットし直した
    [607ZZ Ball.ipt, 607ZZ Inner ring.ipt, 607ZZ Outer ring.ipt, 607ZZ Shield.ipt, 607ZZ.iam, 673 Ball.ipt, 673 Inner ring.ipt, 673 Outer ring.ipt]
2023-04-05 [fix]コミットし直し
    [607ZZ Ball.ipt, 607ZZ Inner ring.ipt, 607ZZ Outer ring.ipt, 607ZZ Shield.ipt, 607ZZ.iam, 673 Ball.ipt, 673 Inner ring.ipt, 673 Outer ring.ipt]
2023-06-16 [fix]配線変更
2023-06-24 [update]iocファイルをアップデート CubeMX6.8.0に対応
